thomasstrand/AVRpsu/AVRpsu/pics/edited/intern_copy.jpg

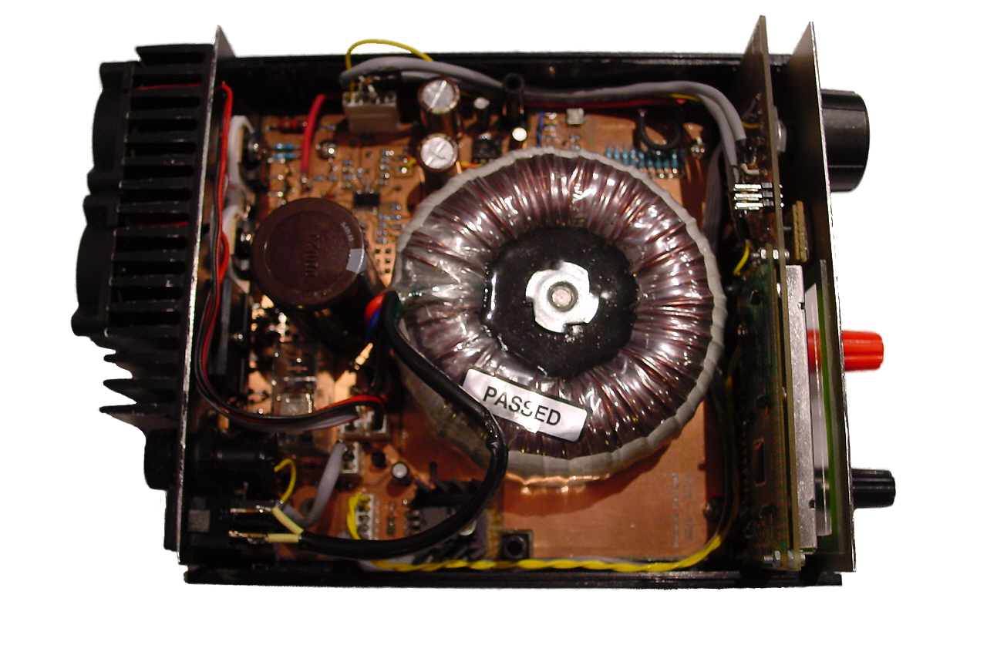
AVRpsu/pics/edited/intern_copy.jpg
