thomasstrand/AVRpsu/AVRpsu/pics/ekstern.jpg

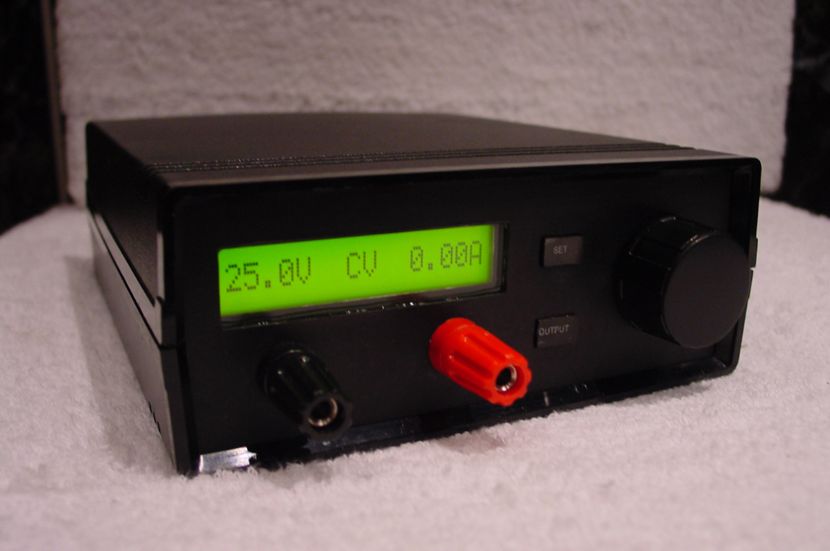
AVRpsu/pics/ekstern.jpg
