thomasstrand/AVRpsu/README.md

Electronics
===========

Schematics, PCB and firmware

Various electronics hobby projects.
Mostly for storage and access on my own part.
