thomasstrand/AVRpsu/AVRpsu/figures/disp_place_top.bmp

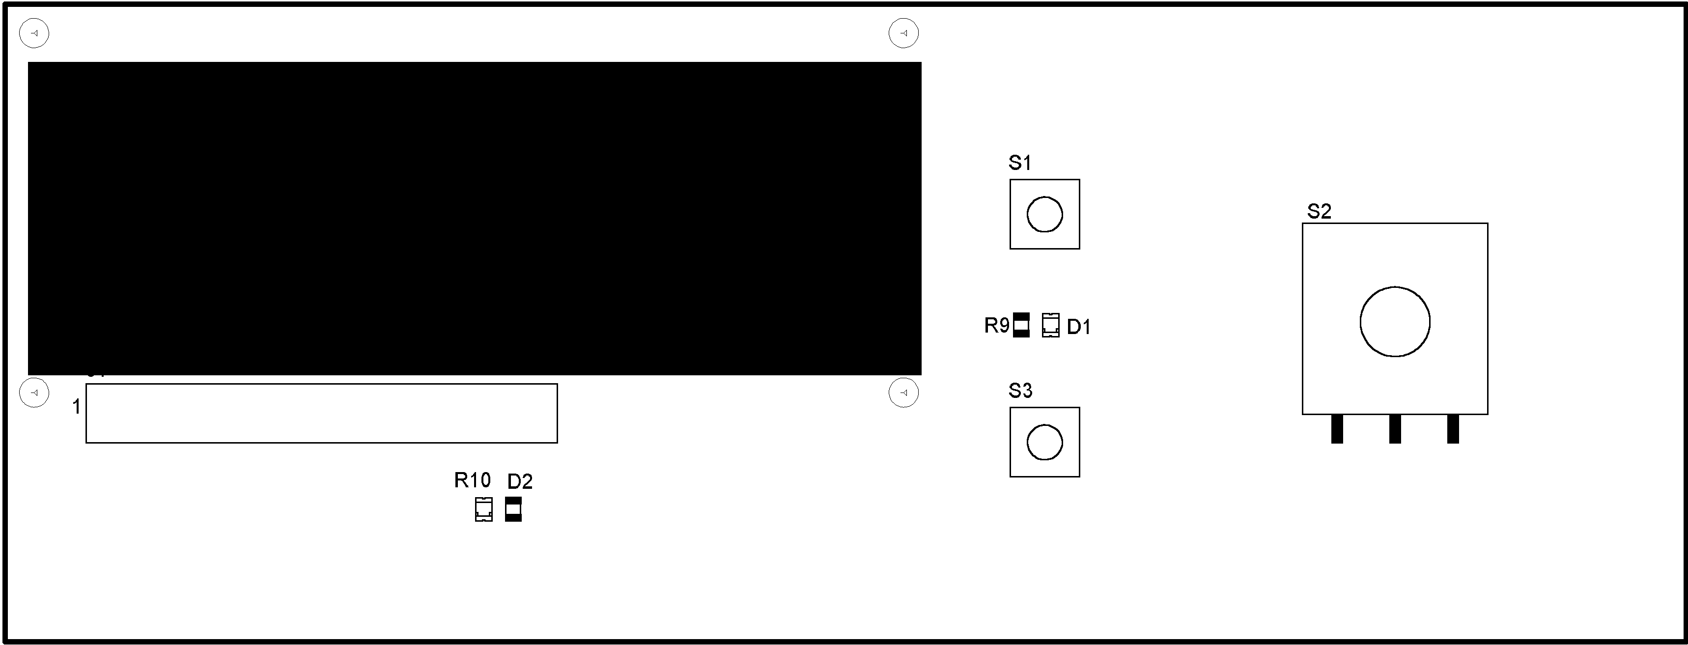
AVRpsu/figures/disp_place_top.bmp
