thomasstrand/AVRpsu/AVRpsu/figures/disp_sch.bmp

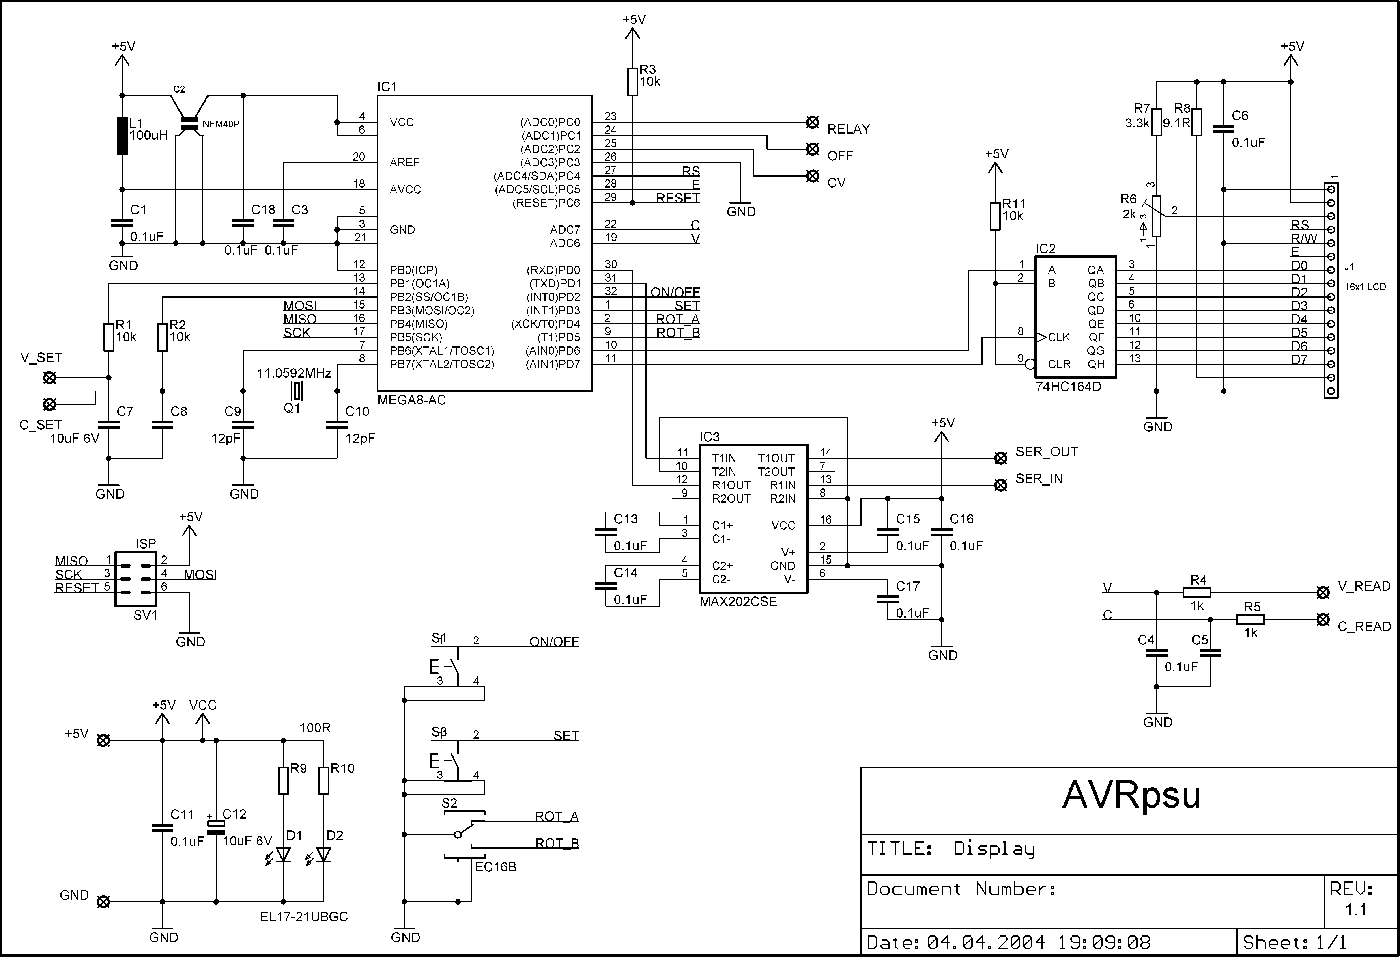
AVRpsu/figures/disp_sch.bmp
