thomasstrand/AVRpsu/AVRpsu/figures/main_bot.bmp

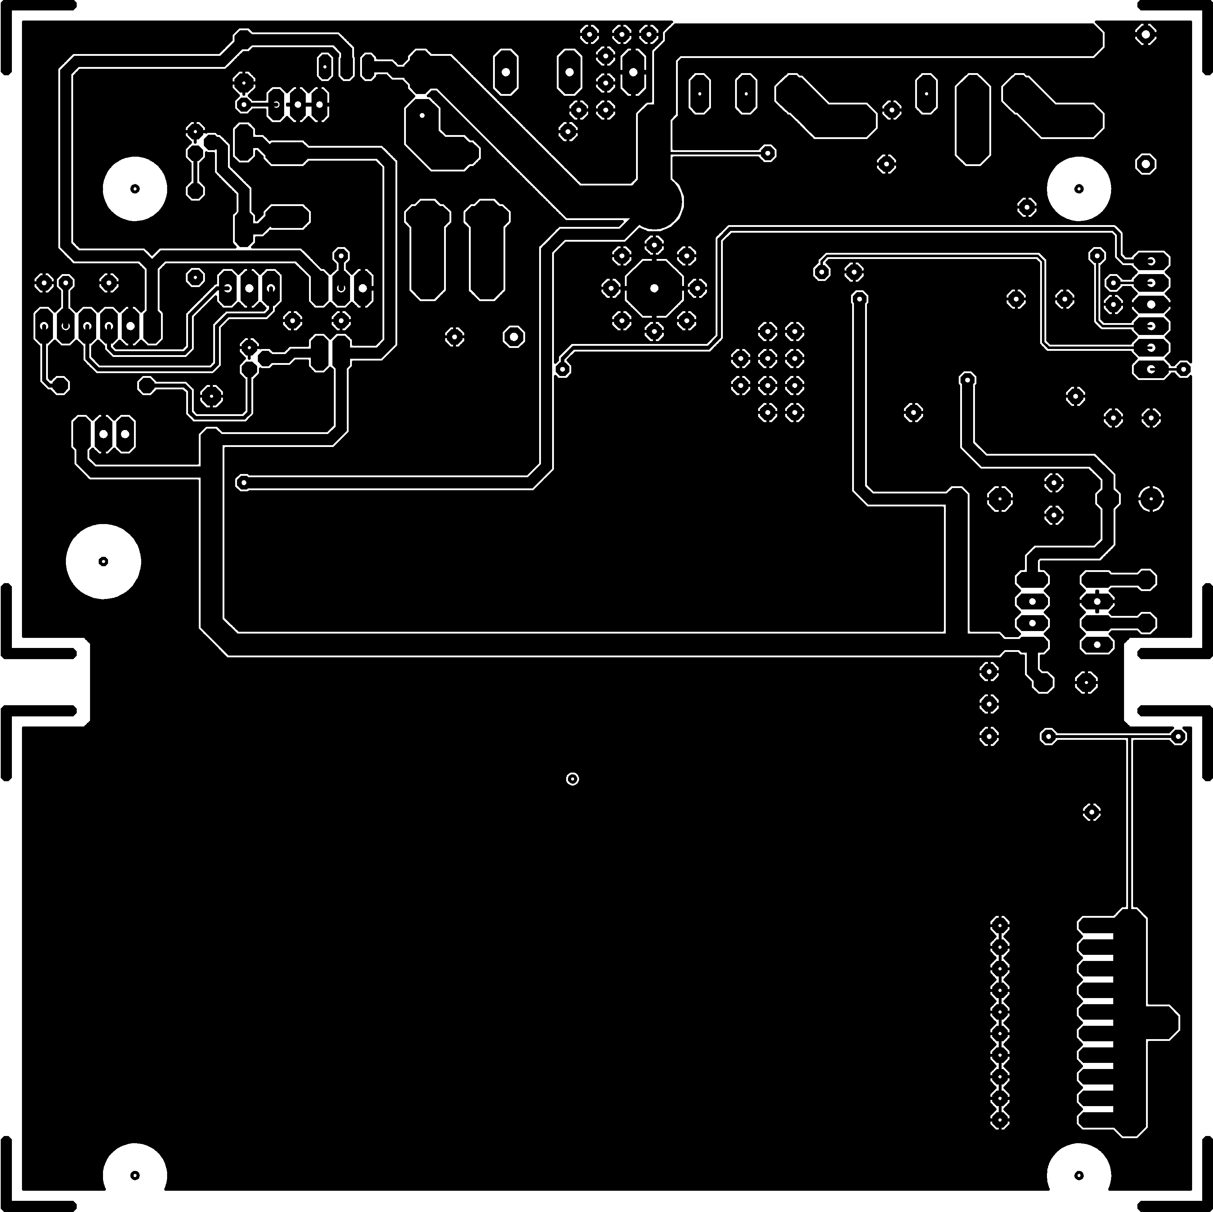
AVRpsu/figures/main_bot.bmp
