thomasstrand/AVRpsu/AVRpsu/figures/main_place.bmp

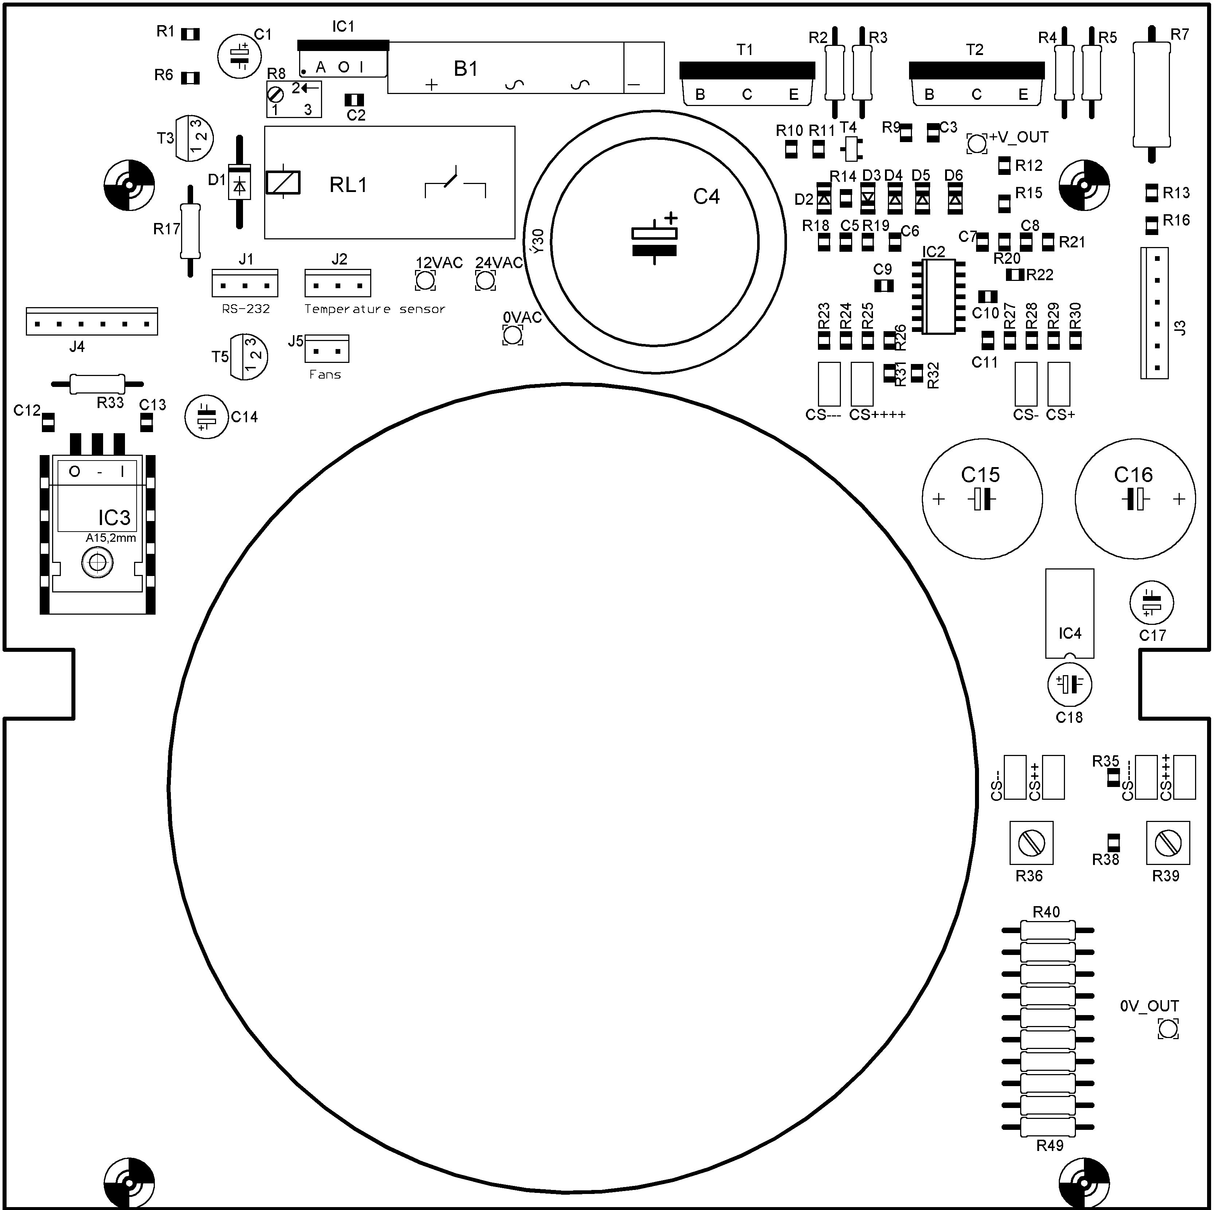
AVRpsu/figures/main_place.bmp
