thomasstrand/AVRpsu/AVRpsu/figures/scope_pics/background_noise.jpg

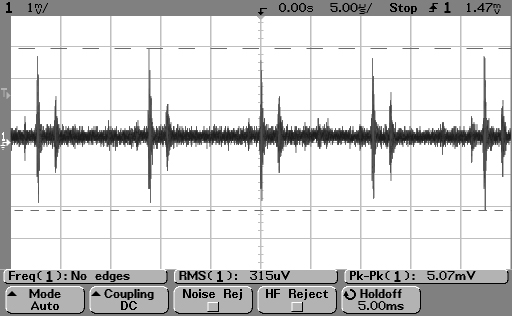
AVRpsu/figures/scope_pics/background_noise.jpg
