thomasstrand/AVRpsu/AVRpsu/figures/scope_pics/noise_no_load_new.jpg

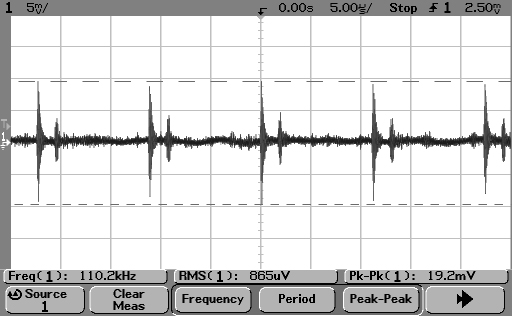
AVRpsu/figures/scope_pics/noise_no_load_new.jpg
