thomasstrand/AVRpsu/AVRpsu/figures/scope_pics/noise_with_load.jpg

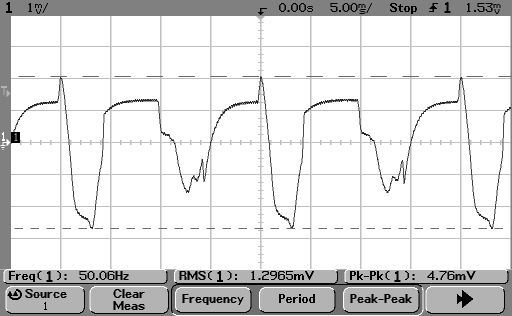
AVRpsu/figures/scope_pics/noise_with_load.jpg
