thomasstrand/AVRpsu/AVRpsu/figures/scope_pics/output_off_on.jpg

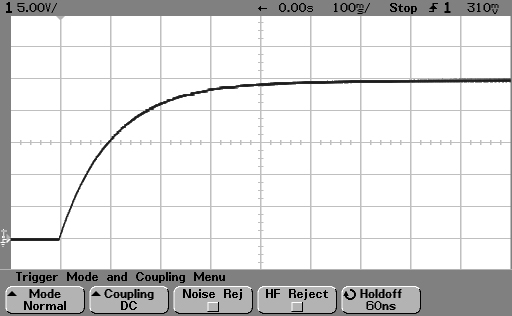
AVRpsu/figures/scope_pics/output_off_on.jpg
