thomasstrand/AVRpsu/AVRpsu/figures/scope_pics/output_on_off.jpg

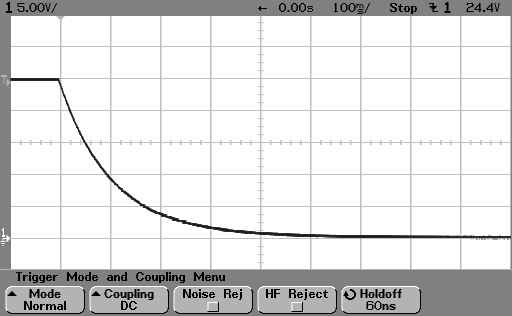
AVRpsu/figures/scope_pics/output_on_off.jpg
