thomasstrand/AVRpsu/AVRpsu/figures/scope_pics/ripple_current_hi.jpg

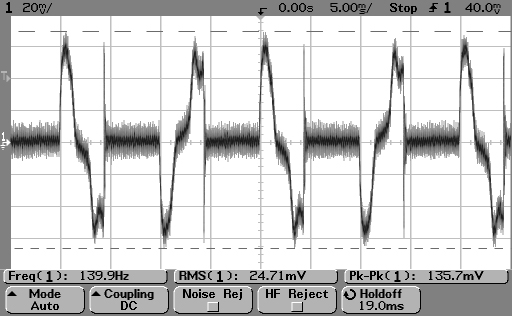
AVRpsu/figures/scope_pics/ripple_current_hi.jpg
