thomasstrand/AVRpsu/AVRpsu/figures/scope_pics/ripple_current_lo.jpg

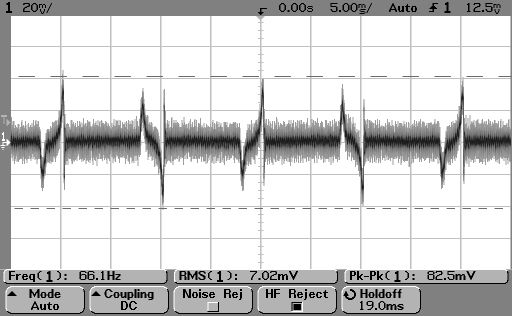
AVRpsu/figures/scope_pics/ripple_current_lo.jpg
