thomasstrand/AVRpsu/AVRpsu/figures/scope_pics/ripple_voltage.jpg

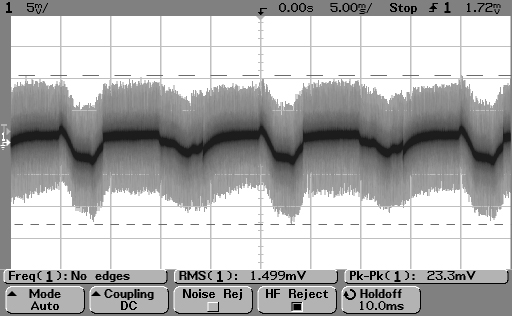
AVRpsu/figures/scope_pics/ripple_voltage.jpg
