thomasstrand/AVRpsu/AVRpsu/figures/scope_pics/rout.jpg

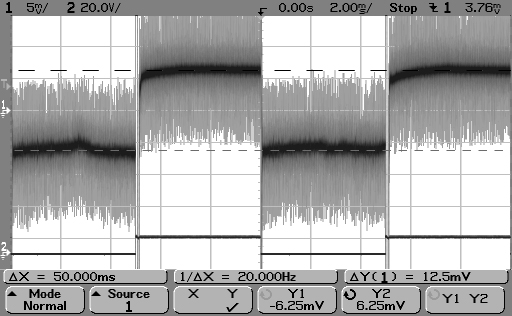
AVRpsu/figures/scope_pics/rout.jpg
