thomasstrand/AVRpsu/AVRpsu/figures/scope_pics/transient_cc_negedge.jpg

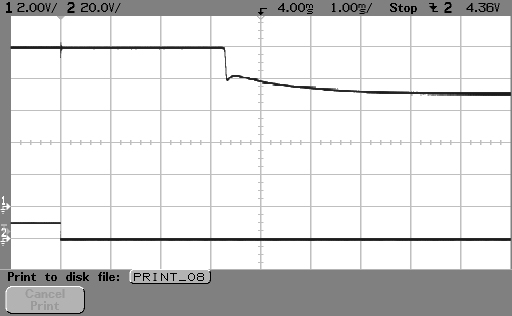
AVRpsu/figures/scope_pics/transient_cc_negedge.jpg
