thomasstrand/AVRpsu/AVRpsu/figures/scope_pics/transient_cc_overview.jpg

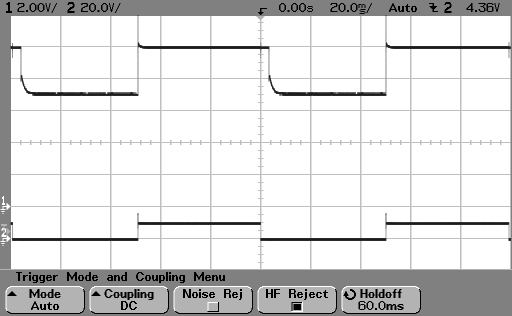
AVRpsu/figures/scope_pics/transient_cc_overview.jpg
