thomasstrand/AVRpsu/AVRpsu/figures/scope_pics/transient_cc_posedge.jpg

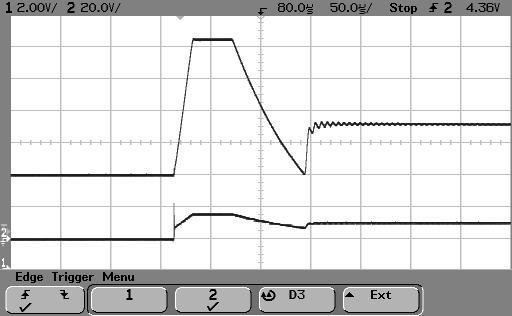
AVRpsu/figures/scope_pics/transient_cc_posedge.jpg
