thomasstrand/AVRpsu/AVRpsu/figures/scope_pics/transient_cv.jpg

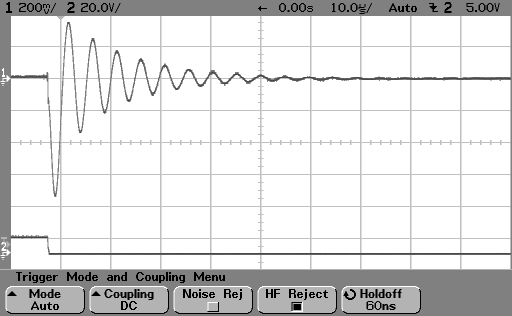
AVRpsu/figures/scope_pics/transient_cv.jpg
