thomasstrand/AVRpsu/AVRpsu/pics/edited/ekstern_copy.jpg

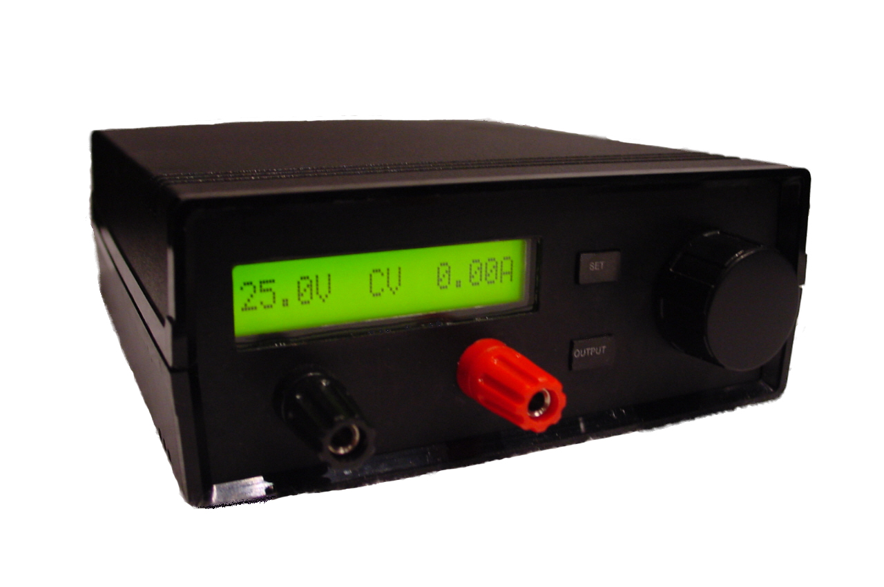
AVRpsu/pics/edited/ekstern_copy.jpg
