thomasstrand/AVRpsu/AVRpsu/pics/ekstern2.jpg

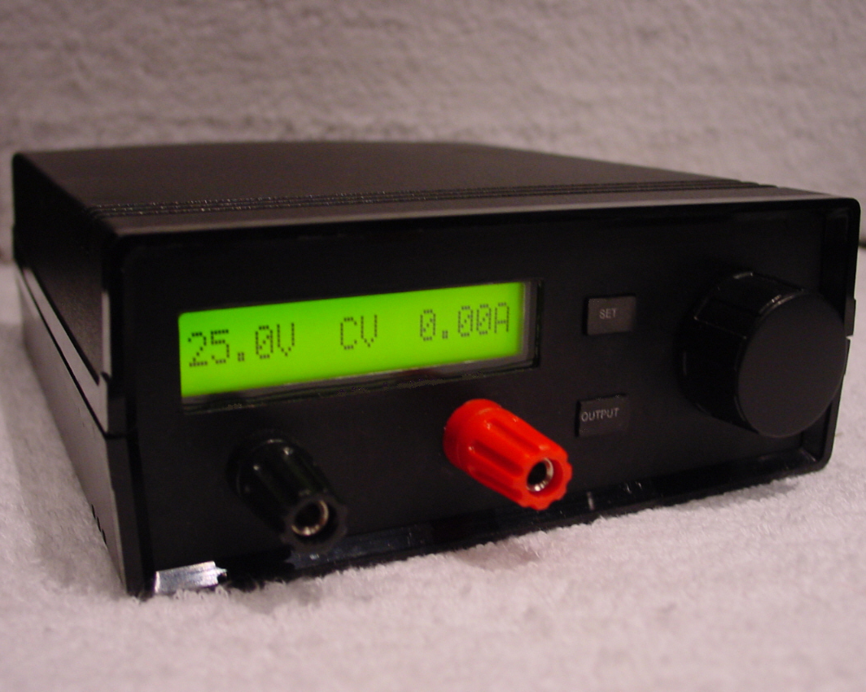
AVRpsu/pics/ekstern2.jpg
