thomasstrand/AVRpsu/AVRpsu/pics/intern.jpg

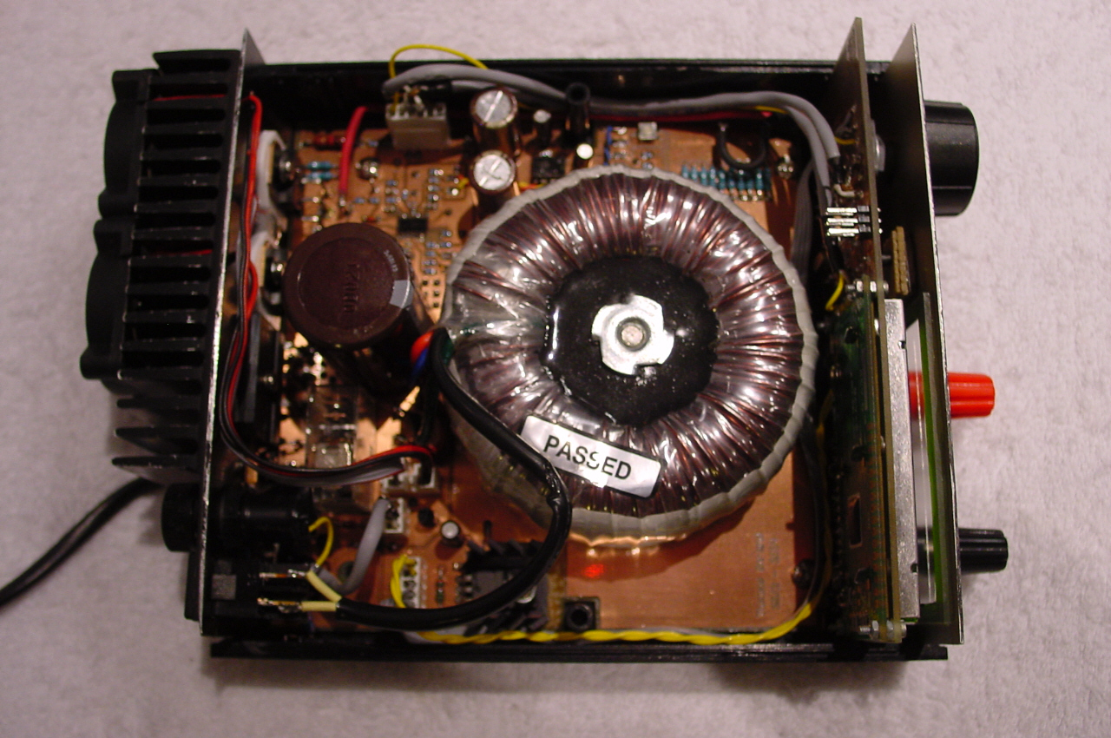
AVRpsu/pics/intern.jpg
