thomasstrand/AVRpsu/AVRpsu/borland_c++_6/avrpsu.cpp

//---------------------------------------------------------------------------

#include <vcl.h>
#pragma hdrstop
//---------------------------------------------------------------------------
USEFORM("main.cpp", MainForm);
//---------------------------------------------------------------------------
WINAPI WinMain(HINSTANCE, HINSTANCE, LPSTR, int)
{
        try
        {
                 Application->Initialize();
                 Application->Title = "AVRpsu";
                 Application->CreateForm(__classid(TMainForm), &MainForm);
                 Application->Run();
        }
        catch (Exception &exception)
        {
                 Application->ShowException(&exception);
        }
        catch (...)
        {
                 try
                 {
                         throw Exception("");
                 }
                 catch (Exception &exception)
                 {
                         Application->ShowException(&exception);
                 }
        }
        return 0;
}
//---------------------------------------------------------------------------
